hpvdt/falcon_propellor_controller/README.md

# Propeller Controller

Firmware and hardware design files for the propeller pitch control board, also used to monitor shaft power.
