hpvdt/falcon_propellor_controller/hardware/propellor_pitch_bluetooth/propellor_pitch_bluetooth.kicad_pcb

## KiCad design hardware/propellor_pitch_bluetooth/propellor_pitch_bluetooth.kicad_pcb (2025-08-17)

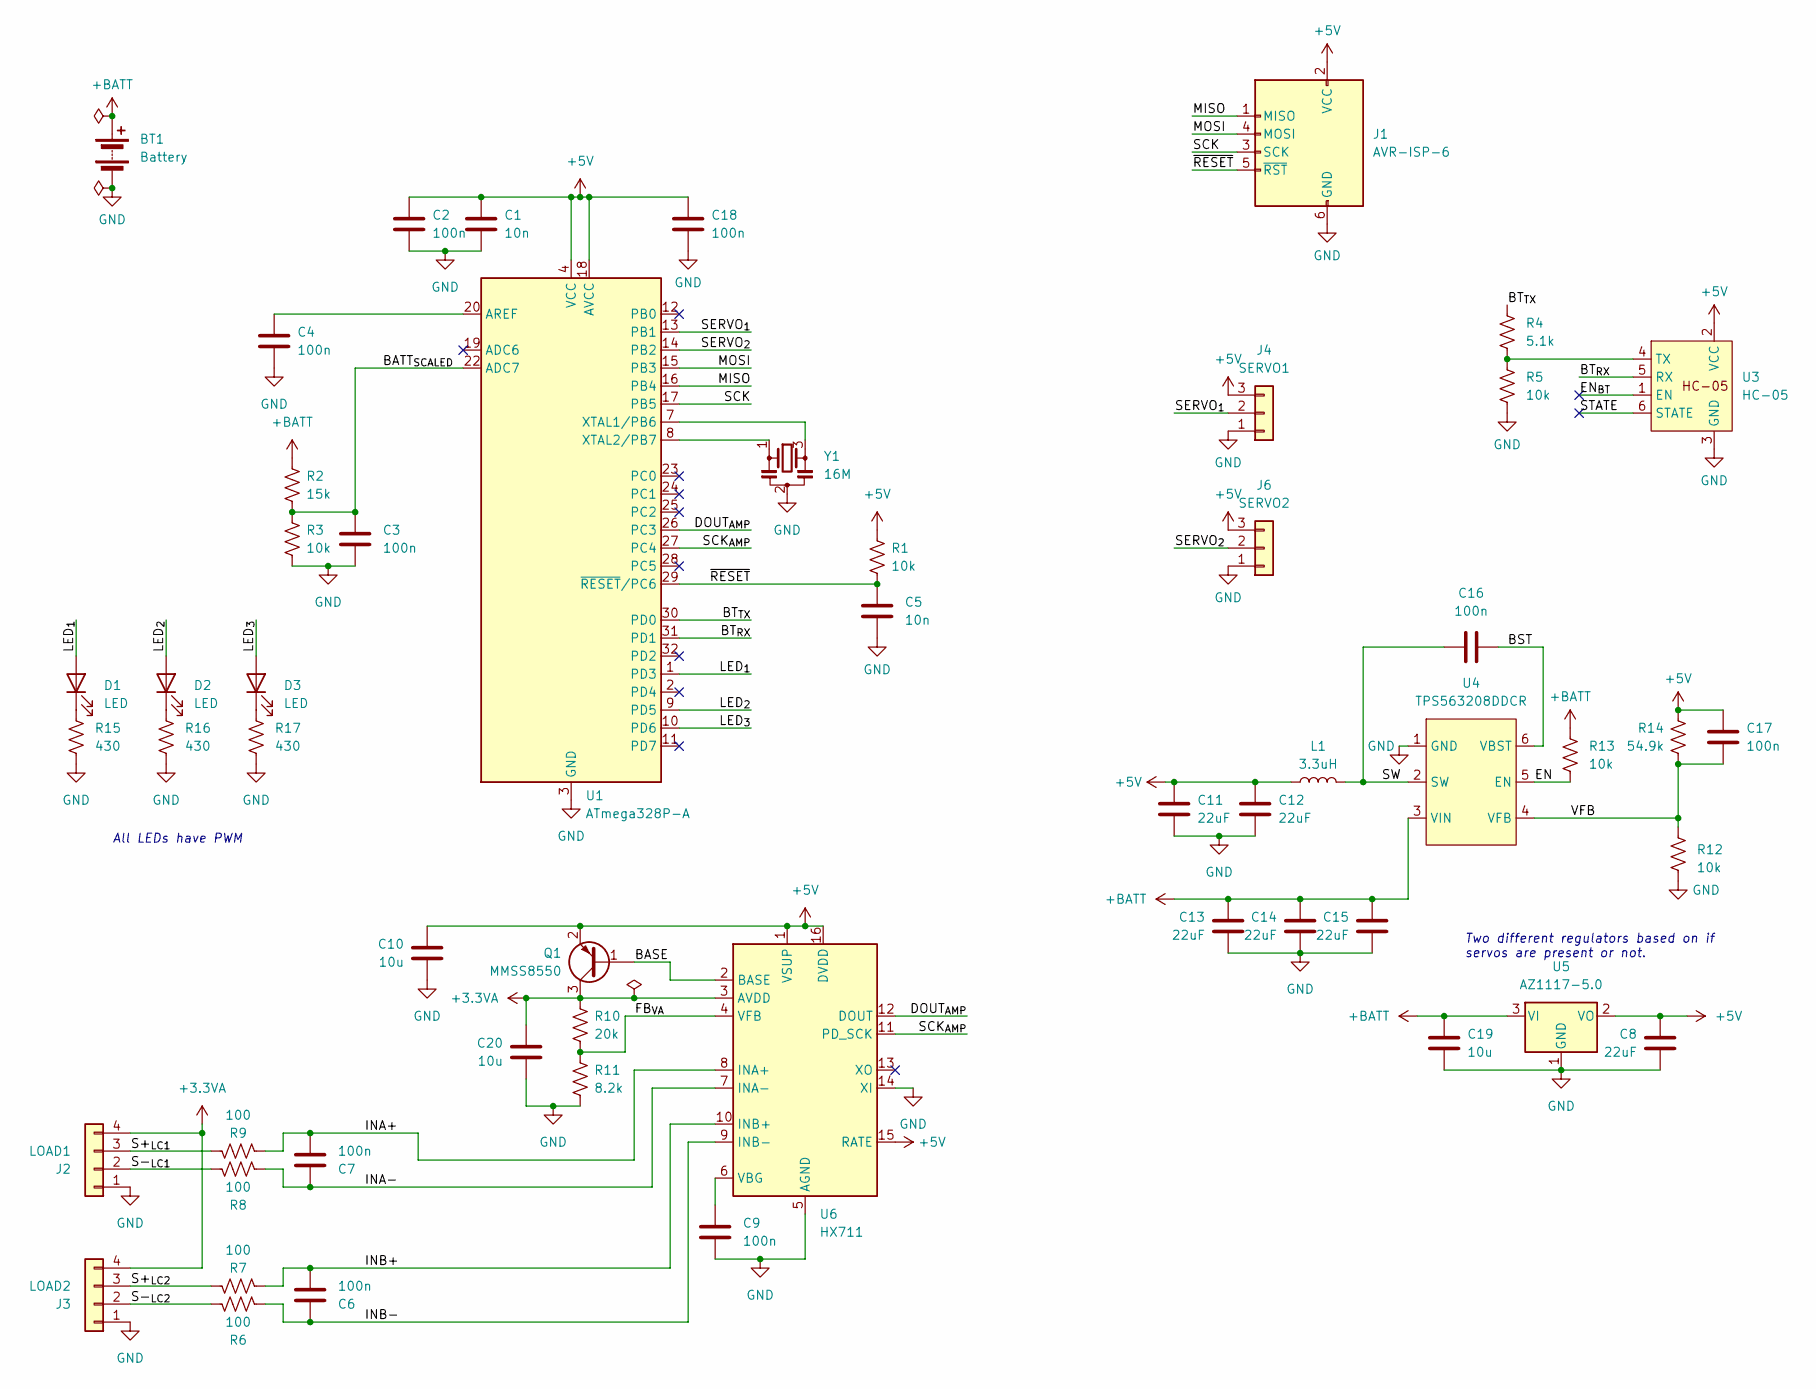
[picture p1: schematic propellor_pitch_bluetooth.kicad_sch, Propellor Pitch Control]

Parts:
BT1: Battery; SolderWire-1.5sqmm_1x02_P6mm_D1.7mm_OD3mm_Relief
C1, C5: 10n; C_0603_1608Metric
C2, C3, C4, C6, C7, C9, C18: 100n; C_0603_1608Metric
C8, C11, C12, C13, C14, C15: 22uF; C_0805_2012Metric
C10, C19, C20: 10u; C_0805_2012Metric
C16, C17: 100n; C_0805_2012Metric
D1, D2, D3: LED; LED_0805_2012Metric
J1: AVR-ISP-6; IDC-Header_2x03_P2.54mm_Vertical_SMD
J2: LOAD1; PinHeader_1x04_P2.54mm_Vertical
J3: LOAD2; PinHeader_1x04_P2.54mm_Vertical
J4: SERVO1; JST_EH_B3B-EH-A_1x03_P2.50mm_Vertical
J6: SERVO2; JST_EH_B3B-EH-A_1x03_P2.50mm_Vertical
L1: 3.3uH; L_Taiyo-Yuden_NR-60xx
Q1: MMSS8550; SOT-23
R1, R3, R5, R12, R13: 10k; R_0603_1608Metric
R2: 15k; R_0603_1608Metric
R4: 5.1k; R_0603_1608Metric
R6, R7, R8, R9: 100; R_0603_1608Metric
R10: 20k; R_0603_1608Metric
R11: 8.2k; R_0603_1608Metric
R14: 54.9k; R_0603_1608Metric
R15, R16, R17: 430; R_0603_1608Metric
U1: ATmega328P-A; TQFP-32_7x7mm_P0.8mm
U3: HC-05; PinHeader_1x06_P2.54mm_Vertical
U4: TPS563208DDCR; TSOT-23-6
U5: AZ1117-5.0; SOT-223-3_TabPin2
U6: HX711; SOP-16_3.9x9.9mm_P1.27mm
Y1: 16M; Resonator_SMD_Murata_CSTxExxV-3Pin_3.0x1.1mm

Connections:
+3.3VA: C20.2, J2.4, J3.4, Q1.3 (C), R10.1, U6.3 (AVDD)
+5V: C1.1, C2.1, C8.2, C10.2, C11.2, C12.2, C17.2, C18.1, J1.2 (VCC), J4.3, J6.3, L1.1, Q1.2 (E), R1.1, R14.1, U1.4 (VCC), U1.6 (VCC), U1.18 (AVCC), U3.2 (VCC), U5.2 (VO), U6.1 (VSUP), U6.15 (RATE), U6.16 (DVDD)
+BATT: BT1.1 (+), C13.2, C14.2, C15.2, C19.2, R2.1, R13.2, U4.3 (VIN), U5.3 (VI)
/BASE: Q1.1 (B), U6.2 (BASE)
/BATT_{SCALED}: C3.1, R2.2, R3.1, U1.22 (ADC7)
/BST: C16.2, U4.6 (VBST)
/BT_{RX}: U1.31 (PD1), U3.5 (RX)
/BT_{TX}: R4.1, U1.30 (PD0)
/DOUT_{AMP}: U1.26 (PC3), U6.12 (DOUT)
/EN: R13.1, U4.5 (EN)
/EN_{BT}: U3.1 (EN)
/FB_{VA}: R10.2, R11.1, U6.4 (VFB)
/INA+: C7.2, R9.2, U6.8 (INA+)
/INA-: C7.1, R8.2, U6.7 (INA-)
/INB+: C6.2, R7.2, U6.10 (INB+)
/INB-: C6.1, R6.2, U6.9 (INB-)
/LED_{1}: D1.2 (A), U1.1 (PD3)
/LED_{2}: D2.2 (A), U1.9 (PD5)
/LED_{3}: D3.2 (A), U1.10 (PD6)
/MISO: J1.1 (MISO), U1.16 (PB4)
/MOSI: J1.4 (MOSI), U1.15 (PB3)
/S+_{LC1}: J2.3, R9.1
/S+_{LC2}: J3.3, R7.1
/S-_{LC1}: J2.2, R8.1
/S-_{LC2}: J3.2, R6.1
/SCK: J1.3 (SCK), U1.17 (PB5)
/SCK_{AMP}: U1.27 (PC4), U6.11 (PD_SCK)
/SERVO_{1}: J4.2, U1.13 (PB1)
/SERVO_{2}: J6.2, U1.14 (PB2)
/STATE: U3.6 (STATE)
/SW: C16.1, L1.2, U4.2 (SW)
/VFB: C17.1, R12.2, R14.2, U4.4 (VFB)
/~RESET: C5.1, J1.5 (~RST), R1.2, U1.29 (~RESET/PC6)
GND: BT1.2 (-), C1.2, C2.2, C3.2, C4.2, C5.2, C8.1, C9.1, C10.1, C11.1, C12.1, C13.1, C14.1, C15.1, C18.2, C19.1, C20.1, J1.6 (GND), J2.1, J3.1, J4.1, J6.1, R3.2, R5.2, R11.2, R12.1, R15.2, R16.2, R17.2, U1.3 (GND), U1.5 (GND), U1.21 (GND), U3.3 (GND), U4.1 (GND), U5.1 (GND), U6.5 (AGND), U6.14 (XI), Y1.2
unnamed: D1.1 (K), R15.1
unnamed: D2.1 (K), R16.1
unnamed: D3.1 (K), R17.1
unnamed: C4.1, U1.20 (AREF)
unnamed: U1.7 (XTAL1/PB6), Y1.3
unnamed: U1.8 (XTAL2/PB7), Y1.1
unnamed: R4.2, R5.1, U3.4 (TX)
unnamed: C9.2, U6.6 (VBG)

Notes on the sheet:
All LEDs have PWM
Two different regulators based on if servos are present or not.

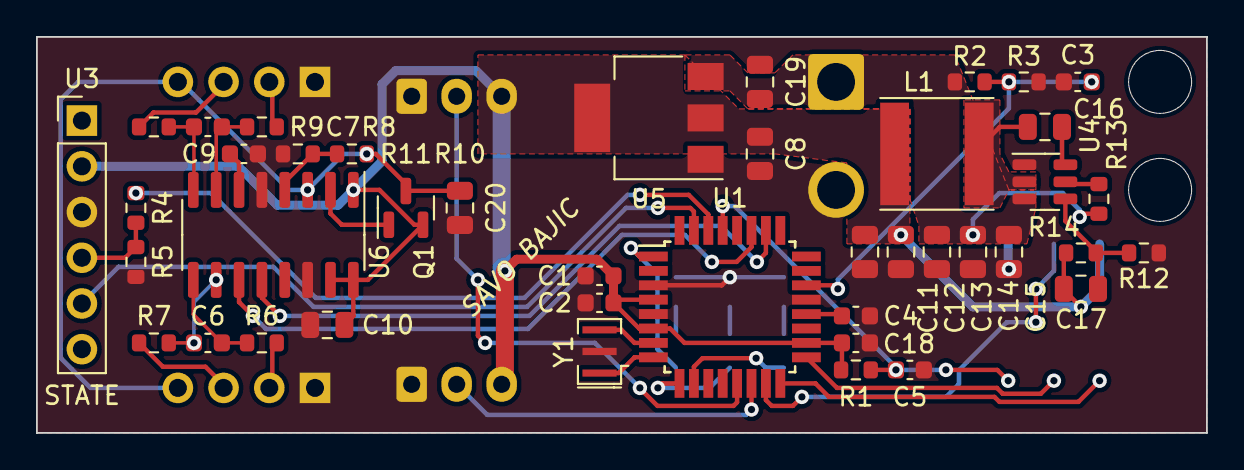
[picture p2: board propellor_pitch_bluetooth.kicad_pcb from above]

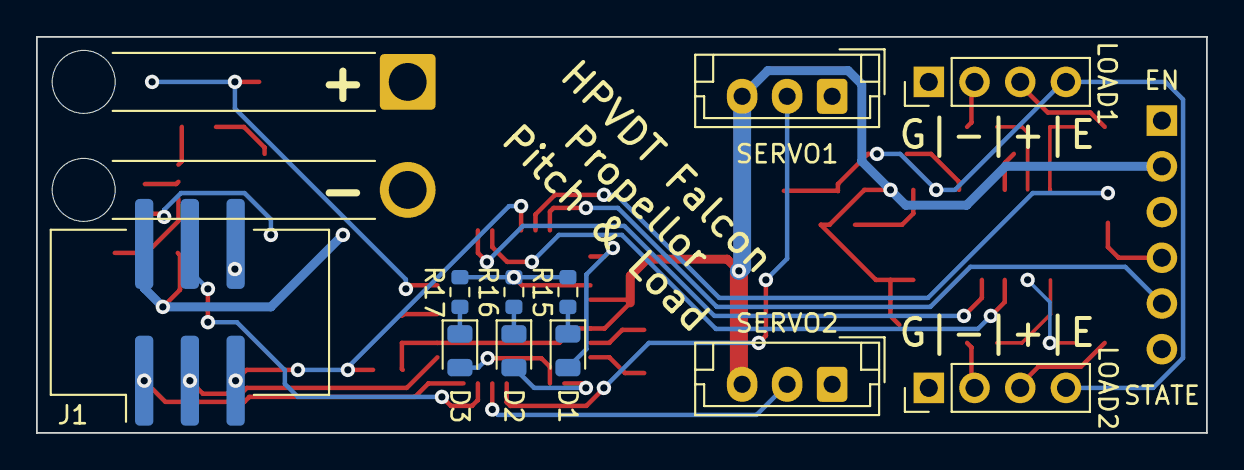
[picture p3: board propellor_pitch_bluetooth.kicad_pcb from below]

Board: 2 copper layers, 65.0 x 22.0 mm, 54 parts (12 on the bottom side), 40 nets.
