hpvdt/falcon_propellor_controller/hardware/propellor_pitch_nrf24/propellor_pitch_nrf24.kicad_pcb

## KiCad design hardware/propellor_pitch_nrf24/propellor_pitch_nrf24.kicad_pcb (2025-08-17)

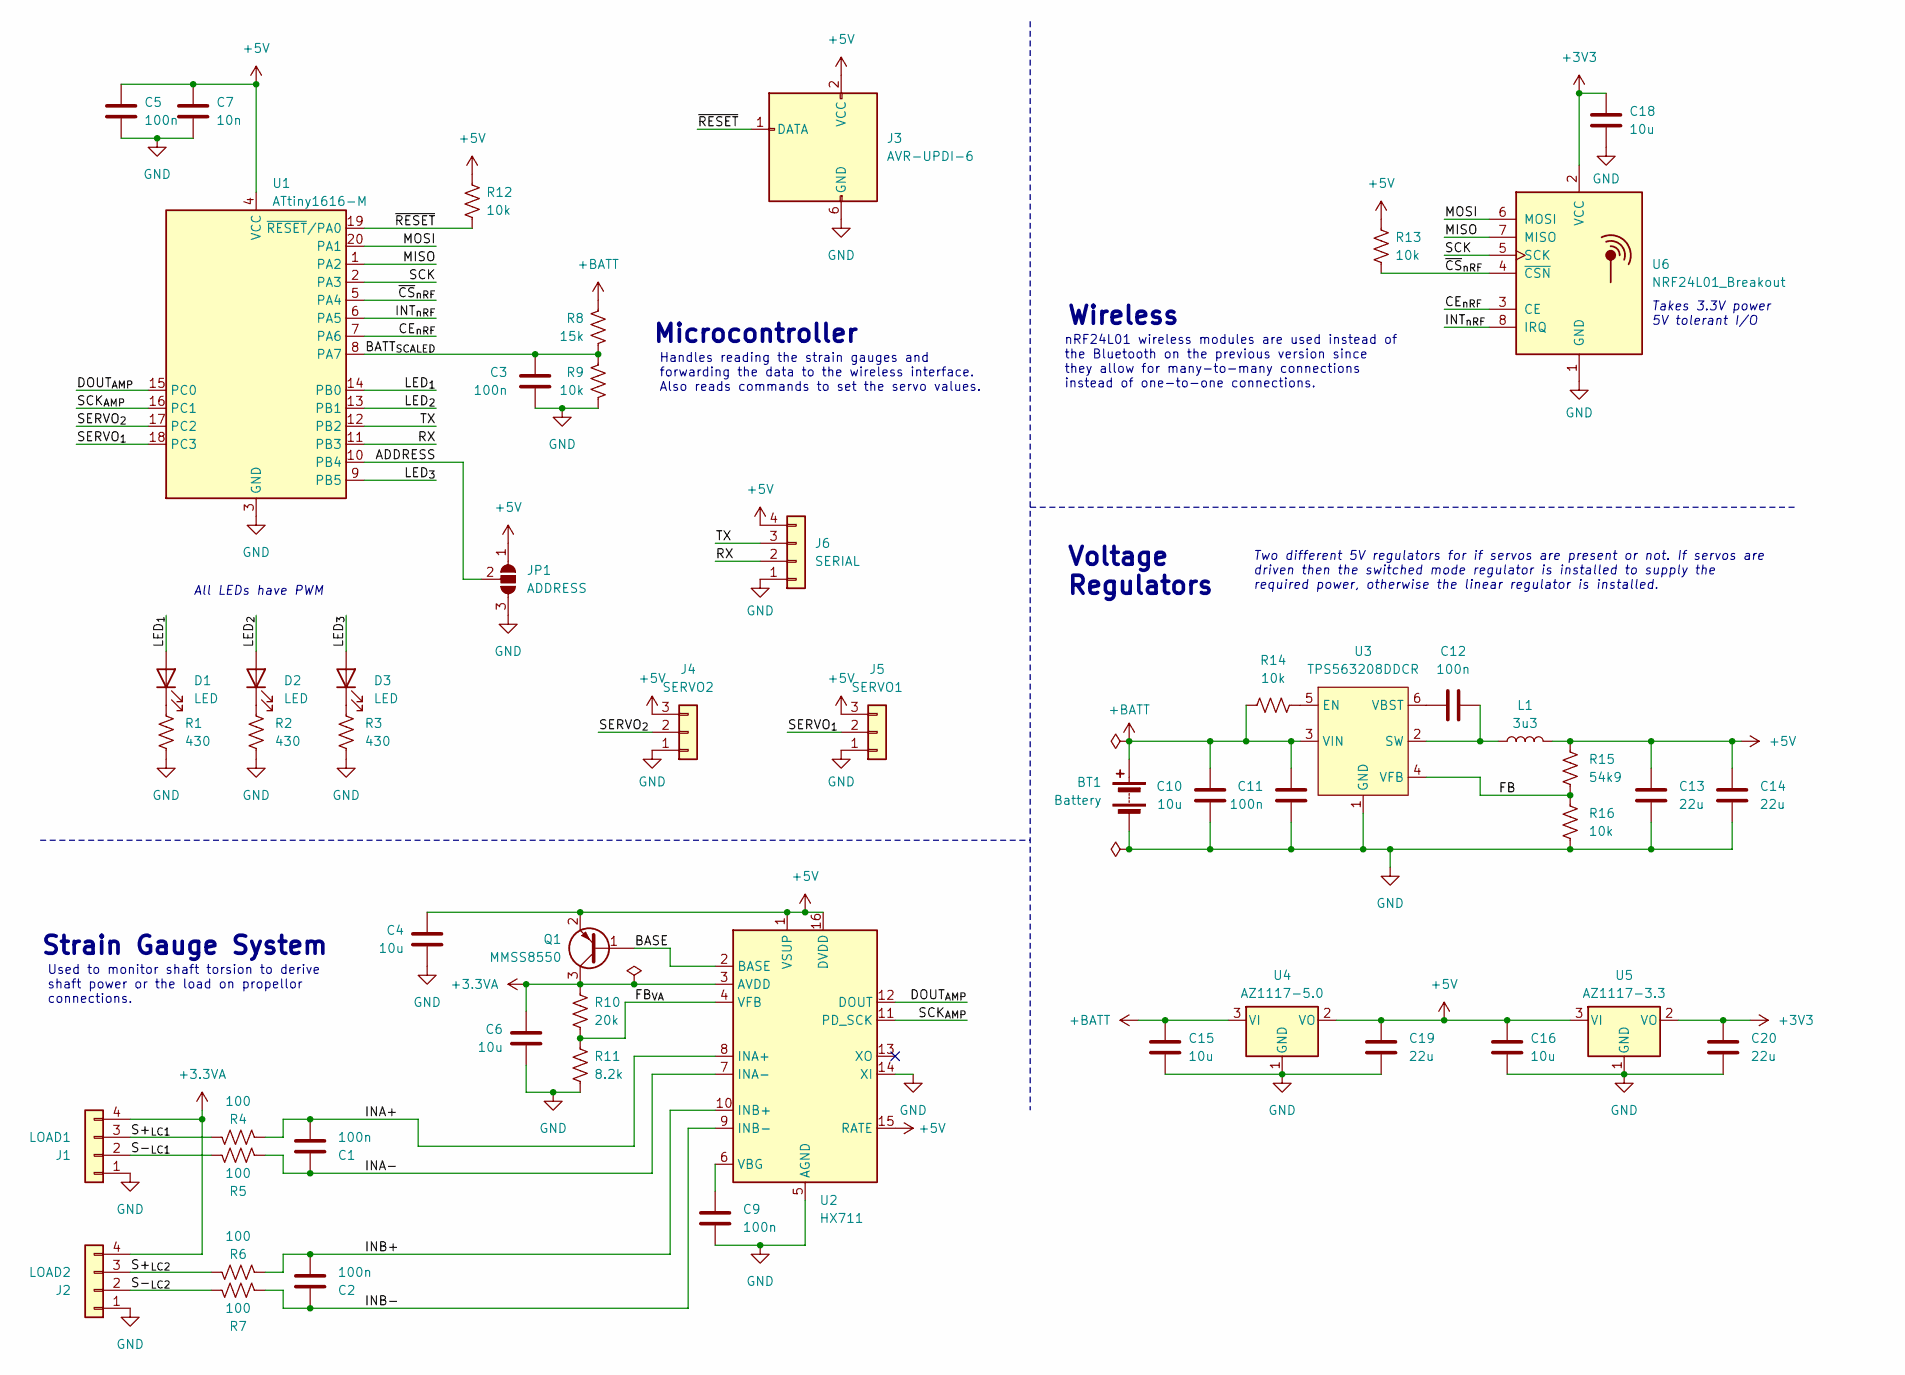
[picture p4: schematic propellor_pitch_nrf24.kicad_sch, Propellor Pitch Control nRF24]

Parts:
BT1: Battery; SolderWire-1.5sqmm_1x02_P6mm_D1.7mm_OD3mm_Relief
C1, C2, C3, C5, C9, C11: 100n; C_0603_1608Metric
C4, C6, C10, C15, C16, C18: 10u; C_0805_2012Metric
C7: 10n; C_0603_1608Metric
C12: 100n; C_0805_2012Metric
C13, C14, C19, C20: 22u; C_0805_2012Metric
D1, D2, D3: LED; LED_0805_2012Metric
J1: LOAD1; PinHeader_1x04_P2.54mm_Vertical
J2: LOAD2; PinHeader_1x04_P2.54mm_Vertical
J3: AVR-UPDI-6; PinHeader_2x03_P2.54mm_Vertical_SMD
J4: SERVO2; JST_EH_B3B-EH-A_1x03_P2.50mm_Vertical
J5: SERVO1; JST_EH_B3B-EH-A_1x03_P2.50mm_Vertical
J6: SERIAL; PinHeader_1x04_P2.54mm_Vertical
JP1: ADDRESS; SolderJumper-3_P1.3mm_Open_Pad1.0x1.5mm
L1: 3u3; L_Taiyo-Yuden_NR-60xx
Q1: MMSS8550; SOT-23
R1, R2, R3: 430; R_0603_1608Metric
R4, R5, R6, R7: 100; R_0603_1608Metric
R8: 15k; R_0603_1608Metric
R9, R12, R13, R14, R16: 10k; R_0603_1608Metric
R10: 20k; R_0603_1608Metric
R11: 8.2k; R_0603_1608Metric
R15: 54k9; R_0603_1608Metric
U1: ATtiny1616-M; VQFN-20-1EP_3x3mm_P0.4mm_EP1.7x1.7mm
U2: HX711; SOP-16_3.9x9.9mm_P1.27mm
U3: TPS563208DDCR; TSOT-23-6
U4: AZ1117-5.0; SOT-223-3_TabPin2
U5: AZ1117-3.3; SOT-223-3_TabPin2
U6: NRF24L01_Breakout; nRF24L01_Breakout

Connections:
+3.3VA: C6.2, J1.4, J2.4, Q1.3 (C), R10.1, U2.3 (AVDD)
+3V3: C18.2, C20.2, U5.2 (VO), U6.2 (VCC)
+5V: C4.2, C5.1, C7.1, C13.2, C14.2, C16.2, C19.2, J3.2 (VCC), J4.3, J5.3, J6.4, JP1.1 (A), L1.2, Q1.2 (E), R12.1, R13.1, R15.1, U1.4 (VCC), U2.1 (VSUP), U2.15 (RATE), U2.16 (DVDD), U4.2 (VO), U5.3 (VI)
+BATT: BT1.1 (+), C10.2, C11.2, C15.2, R8.1, R14.1, U3.3 (VIN), U4.3 (VI)
/ADDRESS: JP1.2 (C), U1.10 (PB4)
/BASE: Q1.1 (B), U2.2 (BASE)
/BATT_{SCALED}: C3.1, R8.2, R9.1, U1.8 (PA7)
/CE_{nRF}: U1.7 (PA6), U6.3 (CE)
/DOUT_{AMP}: U1.15 (PC0), U2.12 (DOUT)
/FB: R15.2, R16.2, U3.4 (VFB)
/FB_{VA}: R10.2, R11.1, U2.4 (VFB)
/INA+: C1.2, R4.2, U2.8 (INA+)
/INA-: C1.1, R5.2, U2.7 (INA-)
/INB+: C2.2, R6.2, U2.10 (INB+)
/INB-: C2.1, R7.2, U2.9 (INB-)
/INT_{nRF}: U1.6 (PA5), U6.8 (IRQ)
/LED_{1}: D1.2 (A), U1.14 (PB0)
/LED_{2}: D2.2 (A), U1.13 (PB1)
/LED_{3}: D3.2 (A), U1.9 (PB5)
/MISO: U1.1 (PA2), U6.7 (MISO)
/MOSI: U1.20 (PA1), U6.6 (MOSI)
/RX: J6.2, U1.11 (PB3)
/S+_{LC1}: J1.3, R4.1
/S+_{LC2}: J2.3, R6.1
/S-_{LC1}: J1.2, R5.1
/S-_{LC2}: J2.2, R7.1
/SCK: U1.2 (PA3), U6.5 (SCK)
/SCK_{AMP}: U1.16 (PC1), U2.11 (PD_SCK)
/SERVO_{1}: J5.2, U1.18 (PC3)
/SERVO_{2}: J4.2, U1.17 (PC2)
/TX: J6.3, U1.12 (PB2)
/~CS_{nRF}: R13.2, U1.5 (PA4), U6.4 (~CSN)
/~RESET: J3.1 (DATA), R12.2, U1.19 (~RESET/PA0)
GND: BT1.2 (-), C3.2, C4.1, C5.2, C6.1, C7.2, C9.1, C10.1, C11.1, C13.1, C14.1, C15.1, C16.1, C18.1, C19.1, C20.1, J1.1, J2.1, J3.6 (GND), J4.1, J5.1, J6.1, JP1.3 (B), R1.2, R2.2, R3.2, R9.2, R11.2, R16.1, U1.3 (GND), U1.21 (GND), U2.5 (AGND), U2.14 (XI), U3.1 (GND), U4.1 (GND), U5.1 (GND), U6.1 (GND)
unnamed: D1.1 (K), R1.1
unnamed: D2.1 (K), R2.1
unnamed: D3.1 (K), R3.1
unnamed: C9.2, U2.6 (VBG)
unnamed: R14.2, U3.5 (EN)
unnamed: C12.2, L1.1, U3.2 (SW)
unnamed: C12.1, U3.6 (VBST)

Notes on the sheet:
Wireless
Voltage Regulators
Microcontroller
Strain Gauge System
Takes 3.3V power 5V tolerant I/O
All LEDs have PWM
nRF24L01 wireless modules are used instead of the Bluetooth on the previous version since they allow for many-to-many connections instead of one-to-one connections.
Handles reading the strain gauges and forwarding the data to the wireless interface. Also reads commands to set the servo values.
Two different 5V regulators for if servos are present or not. If servos are driven then the switched mode regulator is installed to supply the required power, otherwise the linear regulator is installed.
Used to monitor shaft torsion to derive shaft power or the load on propellor connections.

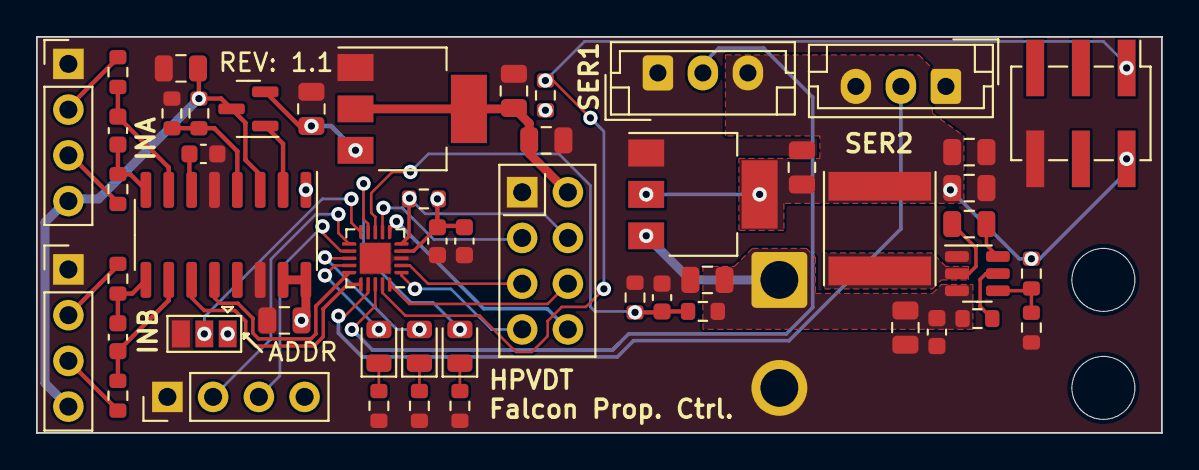
[picture p5: board propellor_pitch_nrf24.kicad_pcb from above]

Board: 2 copper layers, 62.5 x 22.0 mm, 53 parts (1 on the bottom side), 41 nets.
