hpvdt/falcon_propellor_controller/(commit log)

2024-02-10 Servo1 and servo2 connections test (successful)
2024-05-16 Minor touch ups
    - Fixed indentation
    - Set the gain settings to be set correctly to align with the reads for a given channel
    - Re-ordered and cleaned up `setup()`
    [main.cpp]
2024-05-16 Removed servo sweeping code
2024-05-16 Added interpolation for servo angles
2024-08-10 Tidied up pin allocations
2025-08-17 Reorganized repo to add hardware designs
    [propellor_pitch_bluetooth.kicad_pcb, propellor_pitch_bluetooth.kicad_sch, propellor_pitch_nrf24.kicad_pcb, propellor_pitch_nrf24.kicad_sch]
